joslater/MusselGapeTracker_hardware/KiCad_files/MusselGapeTracker_RevI/MusselGapeTracker_RevI_parts_list.xlsx

Sheet: MusselGapeTracker_RevH
MusselGapeTracker RevI
Part Description | Eagle library part | Manufacturer | Mfr. PN | Quantity (for 1 board) | Digikey PN | Digikey $ | Extended $ | Notes | Alt. Manu PN | Alt. Digikey PN | Alt2 Manu PN | Alt2 Digikey PN
Capacitor, surface mount 1uF 35V, electrolytic, Panasonic FC series, size code B | miller.lbr\CPOL-US | Panasonic | EEE-FC1V1R0R | 2 | PCE4024CT-ND | $0.38 | $0.76
Capacitor, 0603 0.1µF 16V ceramic | miller.lbr\CAP | KEMET | C0603C104K4RACTU | 24 | 399-1096-1-ND | $0.08 | $1.92
Capacitor, 0603 4.7µF 10V ceramic | miller.lbr\CAP | KEMET | C0603C475M8PACTU | 1 | 399-9100-1-ND | $0.73 | $0.73
Capacitor, 0603 10µF X5R | miller.lbr\CAP | Yageo | CC0603KRX5R7BB106 | 1 | 311-3486-2-ND | $0.65 | $0.65 | slater substitute
Resistor, 0603 100ohm | miller.lbr\RESISTOR_SMD | Yageo | RC0603JR-07100RL | 2 | 311-100GRCT-ND | $0.10 | $0.20
Resistor, 0603 4.7k ohm | miller.lbr\RESISTOR_SMD | Yageo | RC0603JR-074K7L | 2 | 311-4.7KGRCT-ND | $0.10 | $0.20
Resistor, 0603 10 k ohm | miller.lbr\RESISTOR_SMD | Yageo | RC0603JR-0710KL | 27 | 311-10KGRCT-ND | $0.10 | $2.70
Resistor, 0603 15 k ohm | miller.lbr\RESISTOR_SMD | Yageo | RC0603JR-0715KL | 1 | 311-15KGRCT-ND | $0.10 | $0.10
Resistor, 0603 100 k ohm | miller.lbr\RESISTOR_SMD | Yageo | RC0603JR-07100KL | 4 | 311-100KGRCT-ND | $0.10 | $0.40
LED, Red 0805 | miller.lbr\LED | Lite-On | LTST-C171KRKT | 1 | 160-1427-1-ND | $0.13 | $0.13
LED, Green 0805 | miller.lbr\LED | Lite-On | LTST-C171GKT | 1 | 160-1423-1-ND | $0.12 | $0.12
BJT NPN Transistor 50V 2A SOT23-3 package | miller.lbr\KSC1623_BJT_TRANSISTOR | Diodes Incorporated | FMMT619TA | 1 | FMMT619CT-ND | $0.62 | $0.62 |  | MMBT6429LT1G | MMBT6429LT1GOSCT-ND | ZXTN25020CFHTA | ZXTN25020CFHTACT-ND
Pushbutton switch SPST tactile, SMD | miller.lbr\PUSHBUTTON_DPST_SMD | Omron | B3S-1000P | 3 | SW836CT-ND | $0.59 | $1.77
Hall effect sensor, Allegro A1395 | miller.lbr\HALL_EFFECT_ALLEGRO_A139* | Allegro | A1395SEHLT-T | 16 | 620-1173-6-ND | $1.22 | $19.52
Real Time Clock, DS3231SN# SO-16 footprint |  | Maxim Integrated | DS3231SN# | 1 | DS3231SN#-ND | $17.21 | $17.21 |  | DS3231M+TRL | DS3231M+TRLCT-ND
CR1220 Battery holder | miller.lbr\CR1220_BATTERY_HOLDER | Keystone | 3000 | 1 | 36-3000-ND | $0.40 | $0.40
CR1220 Battery, lithium |  | Panasonic | CR1220 | 1 | P033-ND | $1.03 | $1.03
JST 4-pin connector, male board mount, through hole | miller.lbr\JST-4PIN | JST Sales | B4B-PH-K-S(LF)(SN) | 16 | 455-1706-ND | $0.20 | $3.20
JST 4-pin connector housing, female |  | JST Sales | PHR-4 | 16 | 455-1164-ND | $0.10 | $1.60
JST crimp-on female connector 24-30AWG |  | JST Sales | SPH-002T-P0.5S | 100 | 455-1127-1-ND | $0.04 | $4.09 |  | 2CTC-R | 2057-2CTC-RCT-ND
4x1 Pin header, female, through hole | miller.lbr\PINHD-1x4BIG_LOCK | Sullins | PPTC041LFBN-RC | 1 | S7002-ND | $0.37 | $0.37
40x1 Pin header, male breakaway |  | Sullins | PRPC040SAAN-RC | 1 | S1011EC-40-ND | $0.55 | $0.55
Inductor, 10µH 150mA, 360 mOhm | miller.lbr\INDUCTOR0805 | Taiyo-Yuden | LBR2012T100K | 1 | 587-2045-1-ND | $0.10 | $0.10
3x2 Pin header | miller.lbr\AVR_SPI_PRG_6 | Molex | 901310763 | 1 | WM8139-ND | $1.80 | $1.80
Voltage regulator MCP-1700T-3002 3.0V (or 3.3V version) | miller.lbr\MCP1700T-3002E/TT | Microchip | MCP1700T-3002E/TT | 1 | MCP1700T-3002E/TTCT-ND | $0.51 | $0.51 |  | MCP1700T-3302E/TT | MCP1700T3302ETTCT-ND
P-Channel 20 V 6A (Ta) 1W (Ta) Surface Mount SOT-23F | miller.lbr\MOSFET-PCHANNEL | Toshiba | SSM3J328R,LF | 1 | SSM3J328RLFCT-ND | $0.42 | $0.42 | slater substitute alt for main | BSH203,215 | 1727-6216-1-ND
Shift register 74HC595D | miller.lbr\74HC595D | Texas Instruments | SN74HC595DR | 2 | 296-31822-1-ND | $0.72 | $1.44
MicroSD card slot 5033981892 | miller.lbr\MICROSD_MOLEX_REVERSECURRENT | Molex | 5033981892 | 1 | WM11190CT-ND | $2.62 | $2.62 | slater substitute
CD74HC4067PWR multiplexer 16 channel (24-TSSOP 4.4x7.8mm, 0.65mm pitch) |  | Texas Instruments | CD74HC4067PWR | 1 | 296-CD74HC4067PWRCT-ND | $1.25 | $1.25 | slater substitute
ATmega328P 32-TQFP | miller.lbr\ATMEGA328_SMT | Microchip | ATMEGA328P-AUR | 1 | ATMEGA328P-AURCT-ND | $2.74 | $2.74 |  | ATMEGA328P-AN | ATMEGA328P-AN-ND
Magnet 0.25"diam x 0.063" thick |  | Radial Magnet Inc | 8195 | 16 | 469-1005-ND | $0.18 | $2.88
2.10mm male board-mount Power Barrel jack | miller.lbr\POWER_JACK_2,1MM | CUI | PJ-202AH | 1 | CP-202AH-ND | $0.75 | $0.75
2.10mm ID x 5.50mm OD Power Barrel Connector |  | Memory Protection Devices | EP501A | 1 | EP501A-ND | $1.71 | $1.71
6x1 Female Pin header, right angle through hole 0.1" | miller.lbr\PINHD-1x6RA | Sullins | PPPC061LGBN-RC | 1 | S5481-ND | $0.64 | $0.64
pushbutton surface mount (small, 1.5mm height) | miller.lbr\PUSHBUTTON_SPST_PTS525_SERIES |  | PTS525SM15SMTR2 LFS | 1 | CKN9104CT-ND | $0.67 | $0.67
2x1 Molex KK male connector, through hole | miller.lbr\22-23-2021 | Molex | 22-23-2021 | 1 | WM4200-ND | $0.16 | $0.16 | optional
2x1 Molex KK female connector |  | Molex | 10-11-2023 | 1 | WM2601-ND | $0.14 | $0.14 | optional
Molex KK crimp-on connector, 24-30AWG |  | Molex | 469990101 | 10 | WM5268-ND | $0.15 | $1.50 | optional
 |  |  |  |  |  | Subtotal | $75.80 | (to build one board)
Cabling
4-conductor cable USB-2.0 28gauge 0.150" diameter |  | CNC Tech | 2725-2828-BE-01000-A | 72 | CN306-100-ND | $0.26 | $18.72 | (varies based on length needs), slater substitute
 |  |  |  | ^ft |  | ^/ft
Circuit Boards - OSH Park
MusselGapeTracker_RevI circuit board (order of 3) |  | https://oshpark.com/shared_projects/NMAsMegv |  | 1 |  | $45.2 | $15.06666667 | (3 boards for this price)
Hall effect sensor board (order in multiples of 3, up to 16 per datalogger) |  | https://oshpark.com/shared_projects/4MzgqBxC |  | 16 |  | $0.50 | $8
Stencil - OSH Stencils
MusselGapeTracker RevI stencil |  | https://oshstencils.com |  | 1 |  | $20 | $0 | (one time purchase)
Hall effect sensor board stencil |  | https://oshstencils.com |  | 1
Amazon |  |  |  |  | Internet link
Diymall 0.96" Inch I2c IIC Serial 128x64 Oled LCD LED White Display Module (GND on Pin 1) |  |  |  | 1 | https://www.amazon.com/gp/product/B076PDVFQD/ | $9.99 | $9.99
micro SD card, 8GB |  |  |  | 1 | http://a.co/8pYRSXH | $6.99 | $6.99
 |  |  |  |  |  | Total | $134.57
One-time supplies
Engineer PA-09 crimping pliers |  |  |  | 1 | http://a.co/9MNSbOH | $44.22 | $0.00 | (one time purchase)
PG7 thread tap (for cable gland mounts to box) |  | McMaster-Carr | 2485A11 | 1 | https://www.mcmaster.com/2485A11/ | $64.50 |  | (one time purchase)
Hot air soldering station |  | Sparkfun | 303D | 1 | https://www.sparkfun.com/products/14557 | $129.95
Soldering iron |  | Sparkfun | Weller WE1010 | 1 | https://www.sparkfun.com/products/14734 | $129.00
Box hardware
Cable Feedthrough 2.5mm-6.5mm Polyamide PG7 Black |  | Altech Corporation | 5308 507 | 16 | 1920-1056-ND | $0.89 | $14.24
Yellow Plastic case, 8.7Lx7.45Wx3.89H |  | Serpac | SE120,YL | 1 | SR-R120-Y-ND | $37.10 | $37.10
Heat shrink 1/4" ID x 4ft - moisture proof adhesive lined, semi-rigid |  | TE Connectivity Raychem Cable Protection | DWFR-8/2-0-STK | 1 | DWFR-8/2-0-STK-ND | $10.81 | $10.81 | FIND SUB
Heat shrink tubing, 0.36" ID before, 0.120" after, adhesive lined 4ft length (outer layer) |  | TE Connectivity Raychem Cable Protection | DWP-125-3/8-0-STK | 1 | DWP038K-ND | $9.06 | $9.06
Heat shrink 1/4" ID x 4ft - moisture proof adhesive lined, semi-rigid |  | TE Connectivity | SCL-1/4-0-STK | 1 | SCL-1/4-0-STK-ND |  |  | FIND SUB
Heat shrink - colored assorted 0.25" ID before |  | Qualtek | Q2-F-RK4-1/4-11-6IN-23 | 1 | Q2F18-KIT-ND | $2.48 | $2.48
D-cell battery holder, 4xD |  | Memory Protection Devices | BH4DL | 1 | BH4DL-ND | $3.51 | $3.51
O-ring 1/8 width dash number 206 - McMasterCarr pk 100 https://www.mcmaster.com/4061t228/ |  | 4061T228 | 4061T228 | 16

Sheet: Pin_assignments_RevH
ATMega Pin # | ATMega Pin Name | Net Name | Description
1 | PD3 | BUTTON2 | Button 2 input
2 | PD4 | LED_RED | Red LED output
3 | GND | GND | ground circuit
4 | VCC | VCC | +3V circuit
5 | GND | GND | ground circuit
6 | VCC | VCC | +3V circuit
7 | PB6 | 32KHZ | clock signal input 32.768KHz
8 | PB7 | none | no function
9 | PD5 | MUX_S1 | Multiplexer address line S1
10 | PD6 | MUX_S2 | Multiplexer address line S2
11 | PD7 | MUX_S3 | Multiplexer address line S3
12 | PB0 | MUX_EN | Multiplexer Enable
13 | PB1 | MUX_S0 | Multiplexer address line S0
14 | PB2 | CS_SD | Chip select for SD card
15 | PB3 | MOSI | SPI Master Out Slave In for SD card and 74HC595D shift register SHIFT_0
16 | PB4 | MISO | SPI Master In Slave Out for SD card
17 | PB5 | SCK | SPI clock pin for SD card and 74HC595D shift registers (pin 11 on shift chips)
18 | AVCC | AVCC | Analog voltage supply
19 | ADC6 | BATT_MONITOR | Battery voltage monitor input
20 | AREF | AREF | Analog voltage reference pin
21 | AGND | AGND | Analog ground
22 | ADC7 | ANALOG_0 | Analog signal input from multiplexer
23 | PC0 | BATT_MONITOR_EN | Battery monitor enable
24 | PC1 | SHIFT_CLEAR | Shift register clear (aka MR Master Reset, SRCLR, pin 10 on 74HC595D chip)
25 | PC2 | CS_SHIFT_REG | Chip select for shift registers (aka LATCH, RCLK, or Slave Select, pin 12 on 74HC595D chip)
26 | PC3 | LED_GRN | Green LED output
27 | PC4 | SDA | I2C data line
28 | PC5 | SCL | I2C clock line
29 | PC6 | RESET | Reset pin
30 | PD0 | TO_FTDI_TX | Serial line
31 | PD1 | TO_FTDI_RX | Serial line
32 | PD2 | BUTTON1 | Button 1 input

Sheet: Part_assignments_RevH
Designator | Package | Quantity | Designation | MF | MPN | OC_FARNELL | OC_NEWARK | PACKAGE | PROD_ID | SPICEMODEL | SUPPLIER | VALUE | VALUE2
C55,C56,C8,C66,C53,C65,C62,C23,C3,C59,C58,C6,C54,C69,C52,C50,C9,C64,C4,C57,C61,C63,C5,C7,C60,C51,C68,C67 | 0603 | 28 | 0.1µF capacitor, 0603 size
C10 | 0603 | 1 | 10µF ceramic capacitor, 0603 size
C1,C2 | PANASONIC_B | 2 | 1µF capacitor, Panasonic Series B
R1,R2 | R0603 | 2 | 100 Ω resistor, 0603 size
R7,R8 | R0603 | 2 | 4.7k Ω resisitor, 0603 size
R30 | R0603 | 1 | 15k Ω resistor, 0603 size
R60,R67,R9,R3,R64,R65,R61,R14,R53,R59,R58,R50,R6,R69,R57,R54,R55,R63,R68,R66,R56,R51,R62,R52 | R0603 | 24 | 10k Ω resistor, 0603 size
R32,R33,R29,R31 | R0603 | 4 | 10k Ω resistor, 0603 size
R28 | R0603 | 1 | 10k Ω resistor, 0603 size
R15,R4,R5 | R0603 | 3 | 100k Ω resistor, 0603 size
P-FET | SOT23-3 | 1 | MOSFET-PCHANNEL BSH203
MCP1700T-3302 | SOT95P237X112-3N | 1 | MCP1700T-3302E/TT voltage regulator
BUTTON2,BUTTON1 | PUSHBUTTON_DPST_SMD | 2 | PUSHBUTTON_DPST_SMDSTANDARD
HALL6,HALL9,HALL10,HALL11,HALL15,HALL0,HALL12,HALL8,HALL2,HALL7,HALL13,HALL4,HALL1,HALL14,HALL3,HALL5 | JST-PH-4-THM | 16 | JST-4PINTH_STRAIGHT - JST PH header, 4-pin
SHIFT_1,SHIFT_0 | SO16 | 2 | 74HC595D
U$2 | SSOP24 | 1 | 74HC4067SM96
INDUCTOR | I_0805 | 1 | 10µH inductor, 0805 size
RESET | PUSHBUTTON_SPST_PTS525_SERIES | 1 | PUSHBUTTON_DPST_SMDSMALL
BJT | SOT23 | 1 | KSC1623_BJT_TRANSISTOR
LED1 | CHIPLED_0805 | 1 | RED_LED, 0805 size
LED2 | CHIPLED_0805 | 1 | GREEN_LED, 0805 size
J1 | 2X3 | 1 | AVR_SPI_PRG_6PTH - 2x3 pin header 0.1" spacing
CR1220_BATTERY0 | CR1220_BATTERY_HOLDER_SMD | 1 | CR1220_BATTERY_HOLDERSMD
JP1 | 1X06-RIGHT_ANGLE | 1 | FTDI_HEADER - right angle 1x6 header, 0.1" spacing
MOLEX_KK0 | 22-23-2021 | 1 | Molex KK 2-pin header (optional)
U$1 | MICROSD_SOCKET_MOLEX_REVERSEMOUNT | 1 | MICROSD_MOLEX_REVERSE SD card slot
UNK2,1MM_JACK0 | POWER_JACK_DC_2,1MM | 1 | POWER_JACK_2,1MM
U3 | SOIC-8_3.9x4.9mm_P1.27mm | 1 | DS3231MZ real time clock (or use U2 - DS32313M+)
U2 | SOIC127P1032X265-16N | 1 | DS3231M+TRL (or use U3 - DS3231MZ)
OLED | 1X04_LOCK | 1 | PINHD-1X4LOCK (OLED display header)
U1 | TQFP32-08 | 1 | ATMEGA328P
 |  |  |  |  | MCP1700T-3302E/TT | 1296592 | 88H9817 | SOT23-3 |  |  | Microchip
 |  |  |  | MOLEX | 22-23-2021 | 1462926 | 25C3832
 |  |  |  |  |  |  |  |  | TRANS-08285
 |  |  |  |  |  |  |  |  |  |  |  | ATMEGA328P
