joslater/MusselGapeTracker_hardware/KiCad_files/MusselGapeTracker_RevI/MusselGapeTracker_RevI_PurchaseList.xlsx

MusselGapeTracker RevI Purchase List
Part Description | Quantity (for 1 board) | Digikey PN | Price $ | Extended $ | Purchase Link
One Board Supplies
Digikey
Capacitor, surface mount 1uF 35V, electrolytic, Panasonic FC series, size code B | 4 | PCE4024CT-ND | $0.38 | $1.52 | https://www.digikey.com/en/products/detail/panasonic-industry/EEE-FC1V1R0R/817433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
Capacitor, 0603 0.1µF 16V ceramic | 30 | 399-1096-1-ND | $0.08 | $2.40 | https://www.digikey.com/en/products/detail/kemet/C0603C104K4RACTU/411095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
Capacitor, 0603 4.7µF 10V ceramic | 3 | 399-9100-1-ND | $0.73 | $2.19 | https://www.digikey.com/en/products/detail/kemet/C0603C475M8PACTU/2200892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
Capacitor, 0603 10µF X5R | 3 | 311-3486-2-ND | $0.65 | $1.95 | https://www.digikey.com/en/products/detail/yageo/CC0603KRX5R7BB106/7164370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
Resistor, 0603 100ohm | 4 | 311-100GRCT-ND | $0.10 | $0.40 | https://www.digikey.com/en/products/detail/yageo/RC0603JR-07100RL/726697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
Resistor, 0603 4.7k ohm | 4 | 311-4.7KGRCT-ND | $0.10 | $0.40 | https://www.digikey.com/en/products/detail/yageo/RC0603JR-074K7L/726785
Resistor, 0603 10 k ohm | 30 | 311-10KGRCT-ND | $0.10 | $3.00 | https://www.digikey.com/en/products/detail/yageo/RC0603JR-0710KL/726700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
Resistor, 0603 15 k ohm | 3 | 311-15KGRCT-ND | $0.10 | $0.30 | https://www.digikey.com/en/products/detail/yageo/RC0603JR-0715KL/726717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
Resistor, 0603 100 k ohm | 6 | 311-100KGRCT-ND | $0.10 | $0.60 | https://www.digikey.com/en/products/detail/yageo/RC0603JR-07100KL/726698
LED, Red 0805 | 2 | 160-1427-1-ND | $0.13 | $0.26 | https://www.digikey.com/en/products/detail/liteon/LTST-C171KRKT/386801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
LED, Green 0805 | 2 | 160-1423-1-ND | $0.12 | $0.24 | https://www.digikey.com/en/products/detail/liteon/LTST-C171GKT/386793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
BJT NPN Transistor 45V 0.2A SOT23-3 package | 2 | MMBT6429LT1GOSCT-ND | $0.17 | $0.34 | https://www.digikey.com/en/products/detail/onsemi/MMBT6429LT1G/919618
Pushbutton switch SPST tactile, SMD | 3 | SW836CT-ND | $0.59 | $1.77 | https://www.digikey.com/en/products/detail/omron-electronics-inc-emc-div/B3S-1000P/368390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
Hall effect sensor, Allegro A1395 | 16 | 620-1173-6-ND | $1.22 | $19.52 | https://www.digikey.com/en/products/detail/allegro-microsystems/A1395SEHLT-T/1190025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
Real Time Clock, DS3231SN# SO-16 footprint | 1 | DS3231SN#-ND | $17.21 | $17.21 | https://www.digikey.com/en/products/detail/analog-devices-inc-maxim-integrated/DS3231SN/1197576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
CR1220 Battery holder | 1 | 36-3000-ND | $0.40 | $0.40 | https://www.digikey.com/en/products/detail/keystone-electronics/3000/227440
CR1220 Battery, lithium | 1 | P033-ND | $1.03 | $1.03 | https://www.digikey.com/en/products/detail/panasonic-energy/CR1220/269740
JST 4-pin connector, male board mount, through hole | 16 | 455-1706-ND | $0.20 | $3.20 | https://www.digikey.com/en/products/detail/jst-sales-america-inc/B4B-PH-K-S/926613
JST 4-pin connector housing, female | 16 | 455-1164-ND | $0.10 | $1.60 | https://www.digikey.com/en/products/detail/jst-sales-america-inc/PHR-4/608606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
JST crimp-on female connector 24-30AWG | 100 | 455-1127-1-ND | $0.04 | $4.09 | https://www.digikey.com/en/products/detail/jst-sales-america-inc/SPH-002T-P0-5S/527359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
4x1 Pin header, female, through hole | 1 | S7002-ND | $0.37 | $0.37 | https://www.digikey.com/en/products/detail/sullins-connector-solutions/PPTC041LFBN-RC/810144
40x1 Pin header, male breakaway | 1 | S1011EC-40-ND | $0.55 | $0.55 | https://www.digikey.com/en/products/detail/sullins-connector-solutions/PRPC040SAAN-RC/2775214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
Inductor, 10µH 150mA, 360 mOhm | 3 | 587-2045-1-ND | $0.10 | $0.30 | https://www.digikey.com/en/products/detail/taiyo-yuden/LBR2012T100K/1788937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
3x2 Pin header | 1 | WM8139-ND | $1.80 | $1.80 | https://www.digikey.com/en/products/detail/molex/0901310763/760853?s=N4IgTCBcDaIOoFkAcBGAzATgLQDkAiIAugL5A
Voltage regulator MCP-1700T-3002 3.0V (or 3.3V version) | 1 | MCP1700T-3002E/TTCT-ND | $0.51 | $0.51 | https://www.digikey.com/en/products/detail/microchip-technology/MCP1700T-3002E-TT/651114
P-Channel 20 V 6A (Ta) 1W (Ta) Surface Mount SOT-23F | 1 | SSM3J328RLFCT-ND | $0.42 | $0.42 | https://www.digikey.com/en/products/detail/toshiba-semiconductor-and-storage/SSM3J328R-LF/2753199
Shift register 74HC595D | 2 | 296-31822-1-ND | $0.72 | $1.44 | https://www.digikey.com/en/products/detail/texas-instruments/SN74HC595DRG3/2600341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
MicroSD card slot 5033981892 | 1 | WM11190CT-ND | $2.62 | $2.62 | https://www.digikey.com/en/products/detail/molex/5033981892/4555393?s=N4IgTCBcDaIOoFkCMKCcAGAwgFQLQDkAREAXQF8g
CD74HC4067PWR multiplexer 16 channel (24-TSSOP 4.4x7.8mm, 0.65mm pitch) | 1 | 296-CD74HC4067PWRCT-ND | $1.25 | $1.25 | https://www.digikey.com/en/products/detail/texas-instruments/CD74HC4067PWR/26639687
ATmega328P 32-TQFP | 1 | ATMEGA328P-AURCT-ND | $2.74 | $2.74 | https://www.digikey.com/en/products/detail/microchip-technology/ATMEGA328P-AUR/2357086
Magnet 0.25"diam x 0.063" thick | 16 | 469-1005-ND | $0.18 | $2.88 | https://www.digikey.com/en/products/detail/radial-magnets-inc/8195/555329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
2.10mm male board-mount Power Barrel jack | 1 | CP-202AH-ND | $0.75 | $0.75 | https://www.digikey.com/en/products/detail/same-sky-formerly-cui-devices/PJ-202AH/408450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
2.10mm ID x 5.50mm OD Power Barrel Connector | 1 | EP501A-ND | $1.71 | $1.71 | https://www.digikey.com/en/products/detail/mpd-memory-protection-devices/EP501A/2439550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
6x1 Female Pin header, right angle through hole 0.1" | 1 | S5481-ND | $0.64 | $0.64 | https://www.digikey.com/en/products/detail/sullins-connector-solutions/PPPC061LGBN-RC/775939
pushbutton surface mount (small, 1.5mm height) | 1 | CKN9104CT-ND | $0.67 | $0.67 | https://www.digikey.com/en/products/detail/c-k/PTS525SM15SMTR2-LFS/1146855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
2x1 Molex KK male connector, through hole | 1 | WM4200-ND | $0.16 | $0.16 | https://www.digikey.com/en/products/detail/molex/0022232021/26667?s=N4IgTCBcDaIOoFkAsYAMqC0A5AIiAugL5A
2x1 Molex KK female connector | 1 | WM2601-ND | $0.14 | $0.14 | https://www.digikey.com/en/products/detail/molex/0010112023/171978?s=N4IgTCBcDaIOoFkwDYAMBGAtAOQCIgF0BfIA
Molex KK crimp-on connector, 24-30AWG | 10 | WM5268-ND | $0.15 | $1.50 | https://www.digikey.com/en/products/detail/molex/0469990101/2713548?s=N4IgTCBcDaIOoFkCsYBsAOAtAOQCIgF0BfIA
Amazon
Diymall 0.96" Inch I2c IIC Serial 128x64 Oled LCD LED White Display Module (GND on Pin 1) | 1 |  | $9.99 | $9.99 | https://www.amazon.com/gp/product/B076PDVFQD/
micro SD card, 16GB | 1 |  | $15.90 | $15.90 | http://a.co/8pYRSXH
OSH Park
MusselGapeTracker_RevI circuit board (order of 3) | 1 |  | $32.45 | $10.81666667 | https://oshpark.com/shared_projects/lujm2dur
Hall effect sensor board (order in multiples of 3, up to 16 per datalogger) | 16 |  | $0.50 | $8 | https://oshpark.com/shared_projects/L2bLLtKh
One Time Purchase Supplies
Digikey
4-conductor cable USB-2.0 28gauge 0.150" diameter | 3 | CN306-100-ND | $25.89 | $77.67 | https://www.digikey.com/en/products/detail/cnc-tech/2725-2828-BE-01000-A/6830180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
Amazon
Engineer PA-09 crimping pliers | 1 |  | $38.95 | $0.00 | http://a.co/9MNSbOH
OSH Stencils
MusselGapeTracker RevI stencil | 1 |  | $12.4 | $12.40 | https://www.oshstencils.com/#
Hall effect sensor board stencil | 1 |  | $5 | $5.00 | https://www.oshstencils.com/#
