joslater/MusselGapeTracker_hardware/KiCad_files/MusselGapeTracker_RevI/MusselGapeTracker_RevI.kicad_pcb

## KiCad design KiCad_files/MusselGapeTracker_RevI/MusselGapeTracker_RevI.kicad_pcb (2026-06-09)

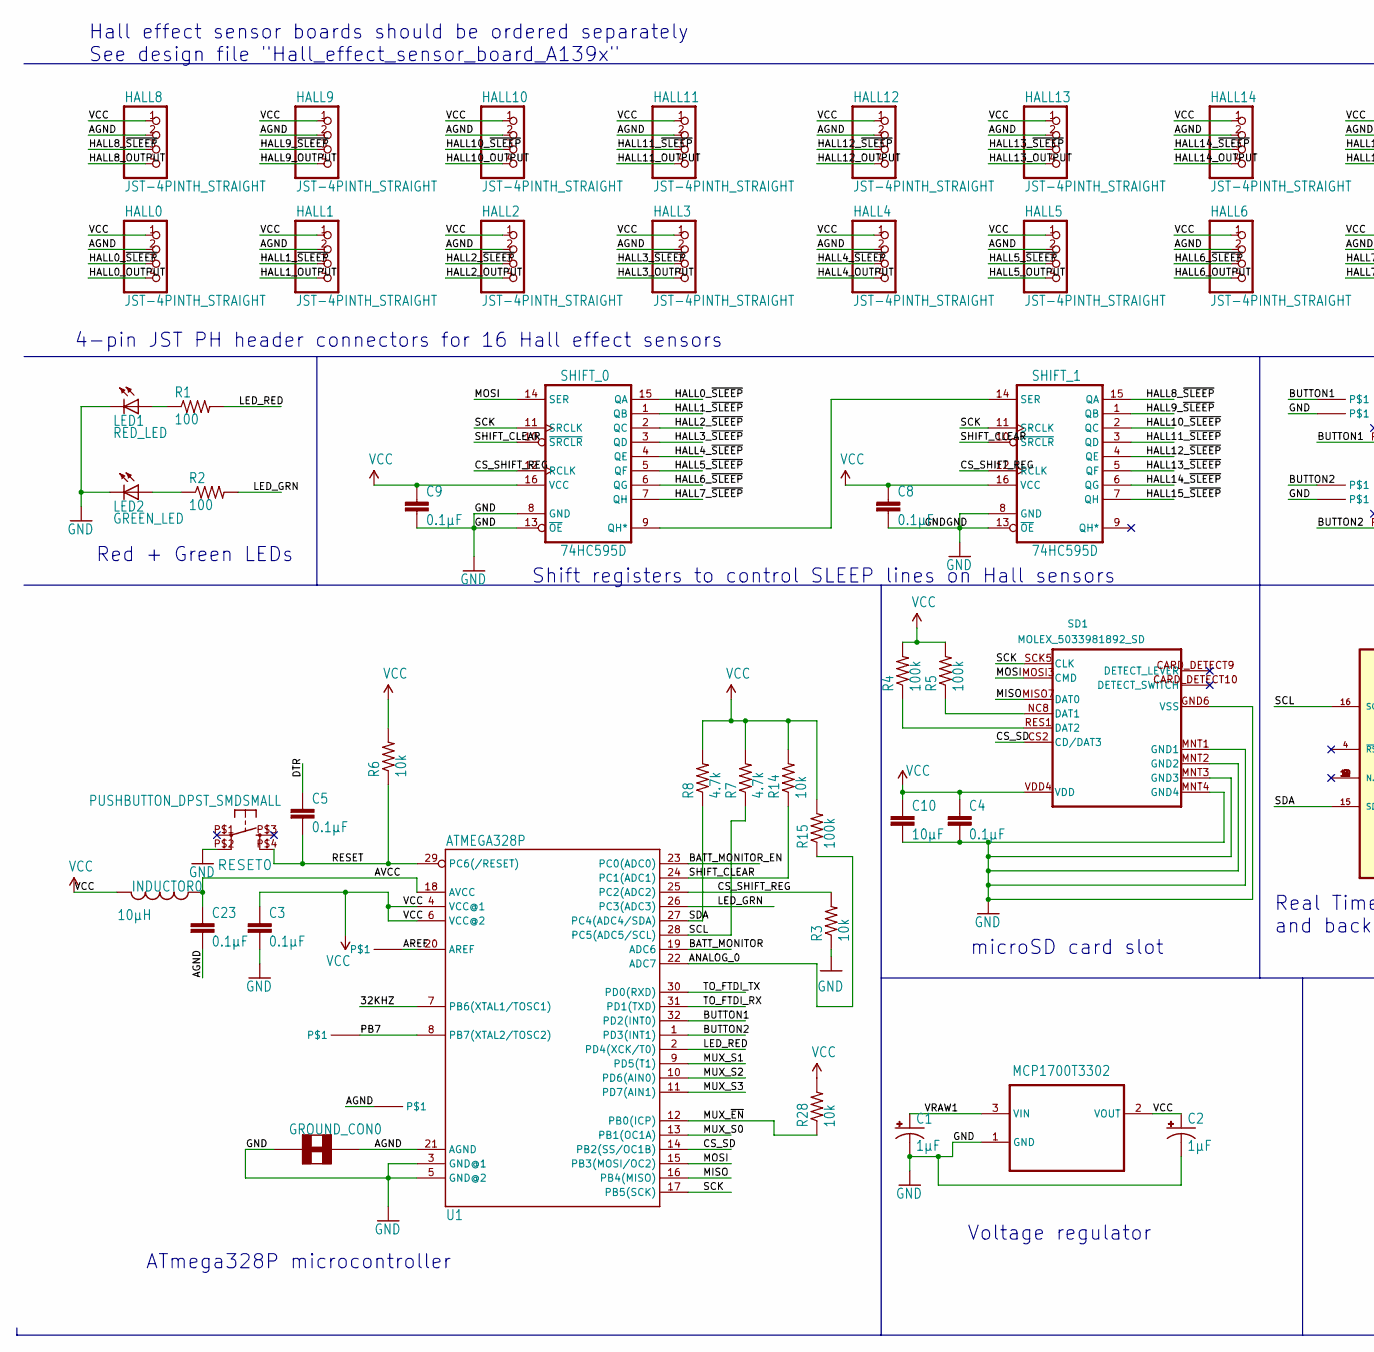
[picture p1: schematic MusselGapeTracker_RevI.kicad_sch, part in row 1, column 1]

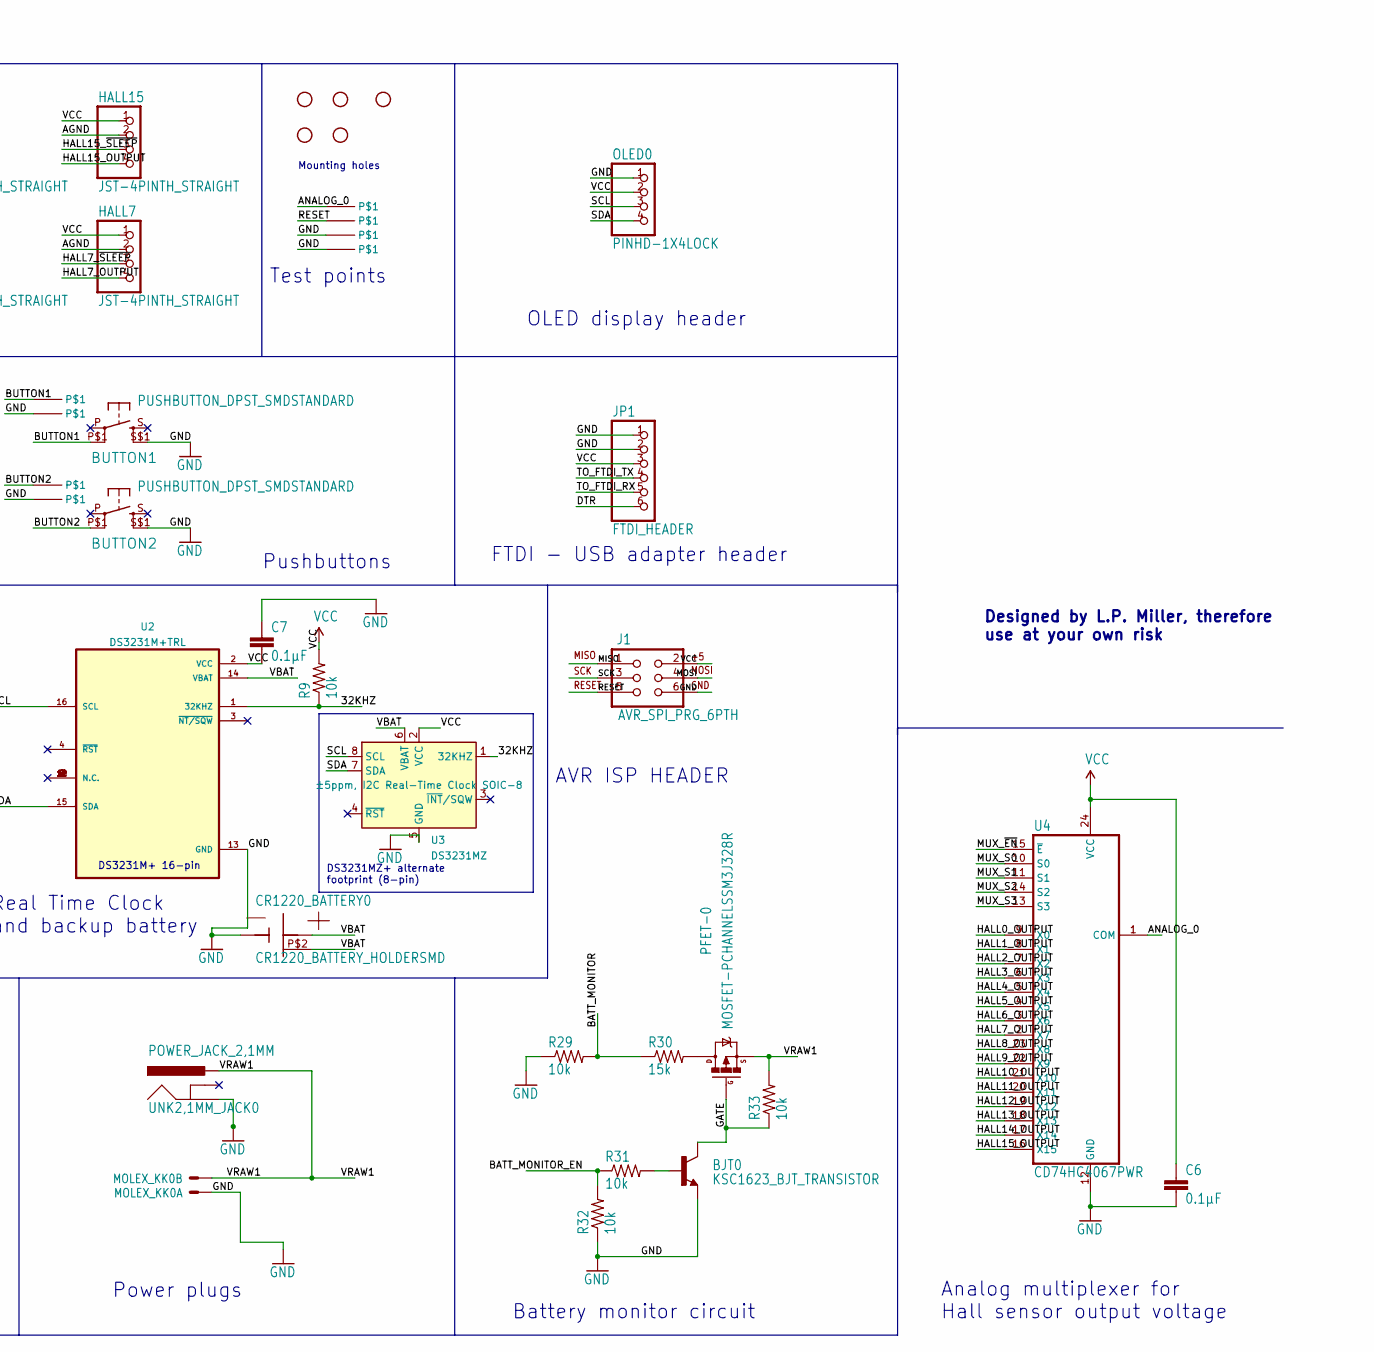
[picture p2: schematic MusselGapeTracker_RevI.kicad_sch, part in row 1, column 2]

Parts:
BJT0: KSC1623_BJT_TRANSISTOR; SOT23
BUTTON1, BUTTON2: PUSHBUTTON_DPST_SMDSTANDARD; PUSHBUTTON_DPST_SMD
C1, C2: 1µF; PANASONIC_B
C3, C4, C5, C6, C7, C8, C9, C23: 0.1µF; R_0603_1608Metric_Pad0.98x0.95mm_HandSolder
C10: 10µF; R_0603_1608Metric_Pad0.98x0.95mm_HandSolder
CR1220_BATTERY0: CR1220_BATTERY_HOLDERSMD; CR1220_BATTERY_HOLDER_SMD
GND0: PINHD-1X1SMALL; 1X01_SMALL
GROUND_CON0: SOLDER_JUMPER_TRACESTANDARD; SJ_2S-TRACE
HALL0, HALL1, HALL2, HALL3, HALL4, HALL5, HALL6, HALL7, HALL8, HALL9, HALL10, HALL11, HALL12, HALL13, HALL14, HALL15: JST-4PINTH_STRAIGHT; JST-PH-4-THM
INDUCTOR0: 10µH; I_0805
J1: AVR_SPI_PRG_6PTH; 2X3
JP1: FTDI_HEADER; 1X06-RIGHT_ANGLE
LED1: RED_LED; CHIPLED_0805
LED2: GREEN_LED; CHIPLED_0805
MCP1700T3302: MCP1700T-3302E/TT; SOT95P237X112-3N
MOLEX_KK0: 22-23-2021
OLED0: PINHD-1X4LOCK; 1X04_LOCK
PB7: PINHD-1X1SMALL; 1X01_SMALL
PFET-0: MOSFET-PCHANNELSSM3J328R; SOT23-3
R1, R2: 100; R_0603_1608Metric_Pad0.98x0.95mm_HandSolder
R3, R6, R9, R14, R28, R29, R31, R32, R33: 10k; R_0603_1608Metric_Pad0.98x0.95mm_HandSolder
R4, R5, R15: 100k; R_0603_1608Metric_Pad0.98x0.95mm_HandSolder
R7, R8: 4.7k; R_0603_1608Metric_Pad0.98x0.95mm_HandSolder
R30: 15k; R_0603_1608Metric_Pad0.98x0.95mm_HandSolder
RESET0: PUSHBUTTON_DPST_SMDSMALL; PUSHBUTTON_SPST_PTS525_SERIES
SD1: MOLEX_5033981892_SD; CONN_503398-1892_MOL; PARTREV A
SHIFT_0, SHIFT_1: 74HC595D; SO16
STANDOFF1, STANDOFF2, STANDOFF3: STAND-OFF4-40; STAND-OFF
STANDOFF4_M2, STANDOFF5_M2: STAND-OFFM2; STAND-OFF_M2
U1: ATMEGA328P; TQFP32-08
U2: DS3231M+TRL; SOIC127P1032X265-16N
U3: DS3231MZ; SOIC-8_3.9x4.9mm_P1.27mm
U4: CD74HC4067PWR; TSSOP-24_4.4x7.8mm_P0.65mm
U$3, U$4, U$6, U$7, U$8, U$9, U$10, U$11, U$17: PINHD-1X1SMALL; 1X01_SMALL
UNK2,1MM_JACK0: POWER_JACK_2,1MM; POWER_JACK_DC_2,1MM

Connections:
/32KHZ: R9.1, U1.7 (PB6(XTAL1/TOSC1)), U2.1 (32KHZ), U3.1 (32KHZ)
/AGND: C23.2, GROUND_CON0.2, HALL0.2, HALL1.2, HALL2.2, HALL3.2, HALL4.2, HALL5.2, HALL6.2, HALL7.2, HALL8.2, HALL9.2, HALL10.2, HALL11.2, HALL12.2, HALL13.2, HALL14.2, HALL15.2, U1.21 (AGND), U$11.1 (P$1_1)
/ANALOG_0: R15.1, U1.22 (ADC7), U4.1 (COM), U$10.1 (P$1_1)
/AREF: U1.20 (AREF), U$17.1 (P$1_1)
/AVCC: C23.1, INDUCTOR0.P$1 (1), U1.18 (AVCC)
/BATT_MONITOR: R29.2, R30.1, U1.19 (ADC6)
/BATT_MONITOR_EN: R31.1, R32.2, U1.23 (PC0(ADC0))
/BUTTON1: BUTTON1.P$1 (P1), U1.32 (PD2(INT0)), U$6.1 (P$1_1)
/BUTTON2: BUTTON2.P$1 (P1), U1.1 (PD3(INT1)), U$8.1 (P$1_1)
/CS_SD: SD1.CS2 (CD/DAT3), U1.14 (PB2(SS/OC1B))
/CS_SHIFT_REG: R3.2, SHIFT_0.12 (RCLK), SHIFT_1.12 (RCLK), U1.25 (PC2(ADC2))
/DTR: C5.1, JP1.6
/GATE: BJT0.3 (C), PFET-0.1 (G), R33.1
/HALL0_OUTPUT: HALL0.4, U4.9 (X0)
/HALL0_~SLEEP: HALL0.3, SHIFT_0.15 (QA)
/HALL1_OUTPUT: HALL1.4, U4.8 (X1)
/HALL1_~SLEEP: HALL1.3, SHIFT_0.1 (QB)
/HALL2_OUTPUT: HALL2.4, U4.7 (X2)
/HALL2_~SLEEP: HALL2.3, SHIFT_0.2 (QC)
/HALL3_OUTPUT: HALL3.4, U4.6 (X3)
/HALL3_~SLEEP: HALL3.3, SHIFT_0.3 (QD)
/HALL4_OUTPUT: HALL4.4, U4.5 (X4)
/HALL4_~SLEEP: HALL4.3, SHIFT_0.4 (QE)
/HALL5_OUTPUT: HALL5.4, U4.4 (X5)
/HALL5_~SLEEP: HALL5.3, SHIFT_0.5 (QF)
/HALL6_OUTPUT: HALL6.4, U4.3 (X6)
/HALL6_~SLEEP: HALL6.3, SHIFT_0.6 (QG)
/HALL7_OUTPUT: HALL7.4, U4.2 (X7)
/HALL7_~SLEEP: HALL7.3, SHIFT_0.7 (QH)
/HALL8_OUTPUT: HALL8.4, U4.23 (X8)
/HALL8_~SLEEP: HALL8.3, SHIFT_1.15 (QA)
/HALL9_OUTPUT: HALL9.4, U4.22 (X9)
/HALL9_~SLEEP: HALL9.3, SHIFT_1.1 (QB)
/HALL10_OUTPUT: HALL10.4, U4.21 (X10)
/HALL10_~SLEEP: HALL10.3, SHIFT_1.2 (QC)
/HALL11_OUTPUT: HALL11.4, U4.20 (X11)
/HALL11_~SLEEP: HALL11.3, SHIFT_1.3 (QD)
/HALL12_OUTPUT: HALL12.4, U4.19 (X12)
/HALL12_~SLEEP: HALL12.3, SHIFT_1.4 (QE)
/HALL13_OUTPUT: HALL13.4, U4.18 (X13)
/HALL13_~SLEEP: HALL13.3, SHIFT_1.5 (QF)
/HALL14_OUTPUT: HALL14.4, U4.17 (X14)
/HALL14_~SLEEP: HALL14.3, SHIFT_1.6 (QG)
/HALL15_OUTPUT: HALL15.4, U4.16 (X15)
/HALL15_~SLEEP: HALL15.3, SHIFT_1.7 (QH)
/LED_GRN: R2.2, U1.26 (PC3(ADC3))
/LED_RED: R1.2, U1.2 (PD4(XCK/T0))
/MISO: J1.1, SD1.MISO7 (DAT0), U1.16 (PB4(MISO))
/MOSI: J1.4, SD1.MOSI3 (CMD), SHIFT_0.14 (SER), U1.15 (PB3(MOSI/OC2))
/MUX_S0: U1.13 (PB1(OC1A)), U4.10 (S0)
/MUX_S1: U1.9 (PD5(T1)), U4.11 (S1)
/MUX_S2: U1.10 (PD6(AIN0)), U4.14 (S2)
/MUX_S3: U1.11 (PD7(AIN1)), U4.13 (S3)
/MUX_~EN: R28.1, U1.12 (PB0(ICP)), U4.15 (~E)
/PB7: PB7.1 (P$1_1), U1.8 (PB7(XTAL2/TOSC2))
/RESET: C5.2, J1.5, R6.1, RESET0.P$4 (S1), U1.29 (PC6(/RESET)), U$3.1 (P$1_1)
/SCK: J1.3, SD1.SCK5 (CLK), SHIFT_0.11 (SRCLK), SHIFT_1.11 (SRCLK), U1.17 (PB5(SCK))
/SCL: OLED0.3, R7.1, U1.28 (PC5(ADC5/SCL)), U2.16 (SCL), U3.8 (SCL)
/SDA: OLED0.4, R8.1, U1.27 (PC4(ADC4/SDA)), U2.15 (SDA), U3.7 (SDA)
/SHIFT_CLEAR: R14.1, SHIFT_0.10 (~SRCLR), SHIFT_1.10 (~SRCLR), U1.24 (PC1(ADC1))
/TO_FTDI_RX: JP1.5, U1.31 (PD1(TXD))
/TO_FTDI_TX: JP1.4, U1.30 (PD0(RXD))
/VBAT: CR1220_BATTERY0.P$1 (VBAT), CR1220_BATTERY0.P$2, U2.14 (VBAT), U3.6 (VBAT)
/VRAW1: C1.+, MCP1700T3302.3 (VIN), MOLEX_KK0.2 (S), PFET-0.2 (S), R33.2, UNK2,1MM_JACK0.P$1 (PWR)
GND: BJT0.2 (E), BUTTON1.S$1 (S1), BUTTON2.S$1 (S1), C1.-, C2.-, C3.2, C4.2, C6.2, C7.1, C8.2, C9.2, C10.2, CR1220_BATTERY0.GND, GND0.1 (P$1_1), GROUND_CON0.1, J1.6, JP1.1, JP1.2, LED1.C, LED2.C, MCP1700T3302.1 (GND), MOLEX_KK0.1 (S), OLED0.1, R3.1, R29.1, R32.1, RESET0.P$2 (P1), SD1.GND6 (VSS), SD1.MNT1 (GND1), SD1.MNT2 (GND2), SD1.MNT3 (GND3), SD1.MNT4 (GND4), SHIFT_0.8 (GND), SHIFT_0.13 (~OE), SHIFT_1.8 (GND), SHIFT_1.13 (~OE), U1.3 (GND@1), U1.5 (GND@2), U2.13 (GND), U3.5 (GND), U4.12 (GND), U$4.1 (P$1_1), U$7.1 (P$1_1), U$9.1 (P$1_1), UNK2,1MM_JACK0.P$2 (GND)
unnamed: BJT0.1 (B), R31.2
unnamed: LED1.A, R1.1
unnamed: LED2.A, R2.1
unnamed: PFET-0.3 (D), R30.2
unnamed: R5.1, SD1.NC8 (DAT1)
unnamed: R4.1, SD1.RES1 (DAT2)
unnamed: SHIFT_0.9 (QH*), SHIFT_1.14 (SER)
VCC: C2.+, C3.1, C4.1, C6.1, C7.2, C8.1, C9.1, C10.1, HALL0.1, HALL1.1, HALL2.1, HALL3.1, HALL4.1, HALL5.1, HALL6.1, HALL7.1, HALL8.1, HALL9.1, HALL10.1, HALL11.1, HALL12.1, HALL13.1, HALL14.1, HALL15.1, INDUCTOR0.P$2 (2), J1.2, JP1.3, MCP1700T3302.2 (VOUT), OLED0.2, R4.2, R5.2, R6.2, R7.2, R8.2, R9.2, R14.2, R15.2, R28.2, SD1.VDD4 (VDD), SHIFT_0.16 (VCC), SHIFT_1.16 (VCC), U1.4 (VCC@1), U1.6 (VCC@2), U2.2 (VCC), U3.2 (VCC), U4.24 (VCC)

Notes on the sheet:
Voltage regulator
OLED display header
DS3231M+ 16-pin
microSD card slot
Real Time Clock and backup battery
Battery monitor circuit
4-pin JST PH header connectors for 16 Hall effect sensors
Hall effect sensor boards should be ordered separately See design file "Hall_effect_sensor_board_A139x"
Pushbuttons
Test points
Designed by L.P. Miller, therefore use at your own risk
ATmega328P microcontroller
FTDI - USB adapter header
Analog multiplexer for Hall sensor output voltage
Power plugs
Mounting holes
Shift registers to control SLEEP lines on Hall sensors
DS3231MZ+ alternate footprint (8-pin)
AVR ISP HEADER
Red + Green LEDs

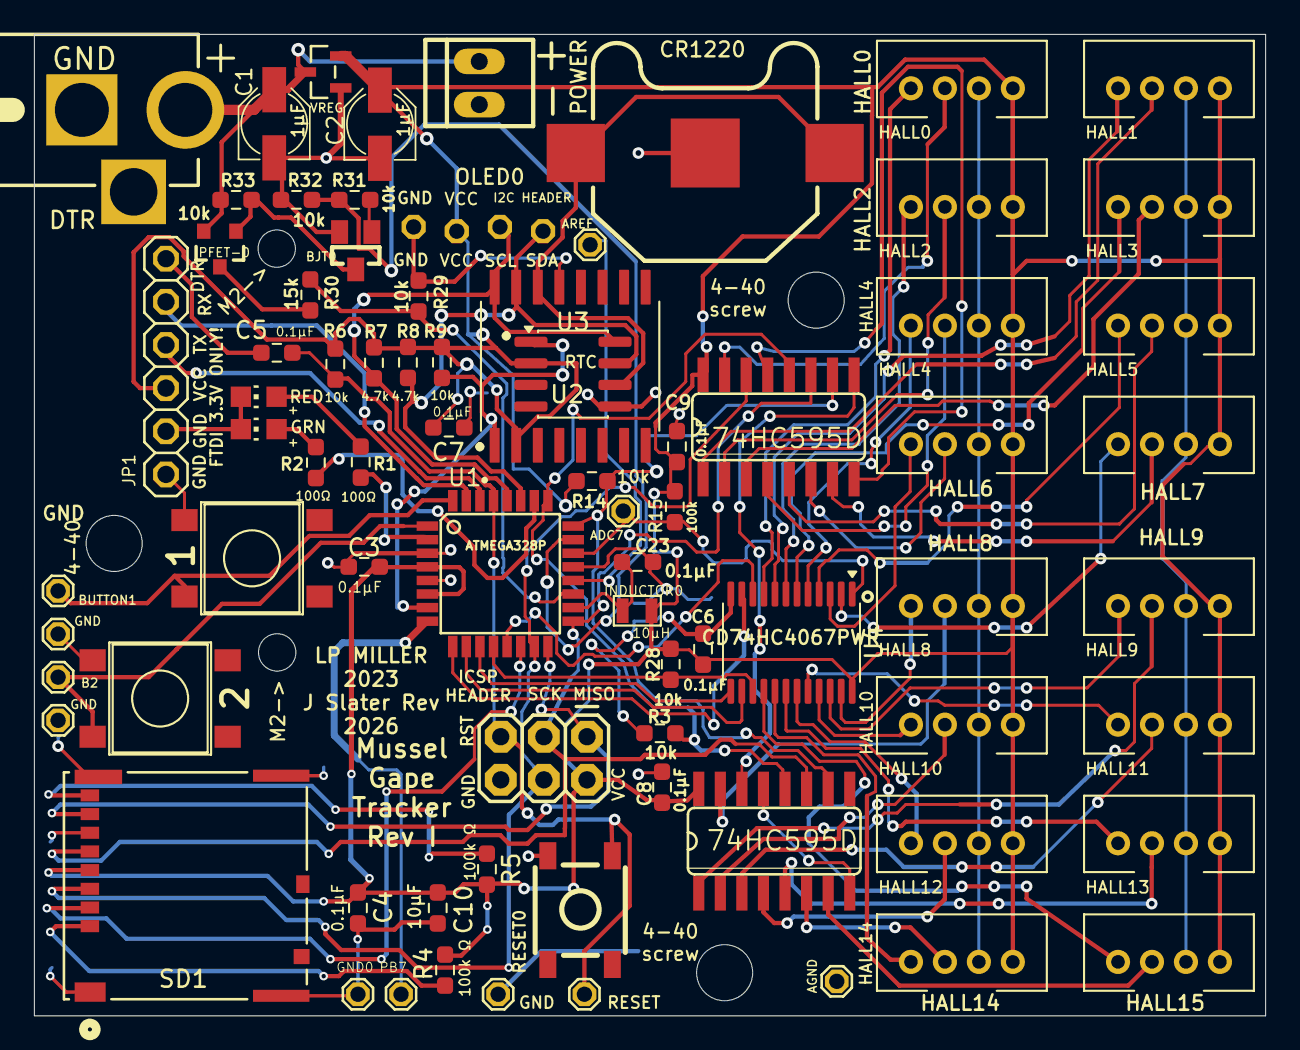
[picture p3: board MusselGapeTracker_RevI.kicad_pcb from above]

Board: 2 copper layers, 72.5 x 57.8 mm, 83 parts (1 on the bottom side), 73 nets.
