joslater/MusselGapeTracker_hardware/KiCad_files/Hall_effect_sensor_board_A139x/Hall_effect_sensor_board_A139x.kicad_pcb

## KiCad design KiCad_files/Hall_effect_sensor_board_A139x/Hall_effect_sensor_board_A139x.kicad_pcb (2026-05-10)

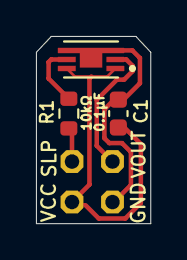
[picture p4: board Hall_effect_sensor_board_A139x.kicad_pcb from above]

Board: 2 copper layers, 6.4 x 10.4 mm, 4 parts (0 on the bottom side), 5 nets.

Parts:
C1: 0.1µF; C_0603_1608Metric
HALL1_HEADER1: PINHD-2X21.5MM_SILK; 2X2_2.25MM
R1: 10kΩ; R_0603_1608Metric
U1: A1395SEHLT-T; SENSOR_A1395SEHLT-T

Connections:
/HALL1_GND: C1.2, HALL1_HEADER1.P$1 (1), U1.3 (GND), U1.4 (GND)
/HALL1_VCC: C1.1, HALL1_HEADER1.P$2 (2), U1.1 (VCC), U1.6 (VREF)
/HALL1_VOUT: HALL1_HEADER1.P$3 (3), U1.2 (OUT)
/HALL1_~SLEEP_IN: HALL1_HEADER1.P$4 (4), R1.1
/~SLEEP1: R1.2, U1.5 (~SLEEP)
