joslater/MusselGapeTracker_hardware/(commit log)

2026-04-09 replace Molex 502774-0891 with GCT MEM2052-00-195-00-A
    [MusselGapeTracker_RevH.kicad_pcb, MusselGapeTracker_RevH.kicad_sch, MusselGapeTracker_RevH_parts_list.xlsx]
2026-04-10 replace Molex 502774-0891 with GCT MEM2052-00-195-00-A
    Pre-existing DRC errors (34) unrelated to this change.
    [MusselGapeTracker_RevH.kicad_pcb]
2026-04-10 Update p-channel mosfet from BSH203 to SSM3J328R
    [MusselGapeTracker_RevH.kicad_pcb, MusselGapeTracker_RevH.kicad_sch, MusselGapeTracker_RevH_parts_list.xlsx]
2026-04-21 Moved changes to Rev I and fixed DRC errors
    Made new copy of KiCad project in Rev I and fixed some electric rules checker errors and warnings and some design rules checker errors and warnings
    [MusselGapeTracker_RevH_parts_list.xlsx, MusselGapeTracker_RevI.kicad_pcb, MusselGapeTracker_RevI.kicad_sch]
2026-04-21 Copied over and updated parts list to Rev I
    [MusselGapeTracker_RevI_parts_list.xlsx]
2026-04-21 Updated parts list with cable sub
    [MusselGapeTracker_RevH_parts_list.xlsx, MusselGapeTracker_RevI_parts_list.xlsx]
2026-05-08 Edits to pcb and parts list
    [MusselGapeTracker_RevI.kicad_pcb]
2026-05-08 parts list edit
    [MusselGapeTracker_RevI_parts_list.xlsx]
2026-05-08 Updated KiCad and Parts list for new SD Card Slot
    Updated KiCad schematic, PCB, and parts list for new SD card slot Molex 5033981892
    [MusselGapeTracker_RevI.kicad_pcb, MusselGapeTracker_RevI.kicad_sch, MusselGapeTracker_RevI_parts_list.xlsx]
2026-05-10 Fix PCB DRC errors and updated parts list
    Updated parts list for more accurate DS3231 chip
    [MusselGapeTracker_RevI.kicad_pcb, MusselGapeTracker_RevI_parts_list.xlsx]
2026-05-10 Created purchase list
    [MusselGapeTracker_RevI.kicad_pcb, MusselGapeTracker_RevI_PurchaseList.xlsx, MusselGapeTracker_RevI_parts_list.xlsx]
2026-05-10 Generate gerber files
    [Hall_effect_sensor_board_A139x-B_Cu.gbr, Hall_effect_sensor_board_A139x-B_Mask.gbr, Hall_effect_sensor_board_A139x-B_Paste.gbr, Hall_effect_sensor_board_A139x-B_Silkscreen.gbr, Hall_effect_sensor_board_A139x-Edge_Cuts.gbr, Hall_effect_sensor_board_A139x-F_Cu.gbr, Hall_effect_sensor_board_A139x-F_Mask.gbr, Hall_effect_sensor_board_A139x-F_Paste.gbr]
2026-05-10 Update purchase list
    [MusselGapeTracker_RevI_PurchaseList.xlsx]
2026-06-03 Fixed SD card mount traces
    Ran SD card traces on bottom instead of top to avoid sd mount prohibition area
    [MusselGapeTracker_RevI.kicad_pcb, MusselGapeTracker_RevI.kicad_sch, MusselGapeTracker_RevI_PurchaseList.xlsx, MusselGapeTracker_RevI_SMT_BOM.csv, MusselGapeTracker_RevI_parts_list.xlsx]
2026-06-09 Generated new gerbers
    Generated new gerber files after modifying SD card traces
    [MusselGapeTracker_RevI-B_Cu.gbr, MusselGapeTracker_RevI-B_Mask.gbr, MusselGapeTracker_RevI-B_Paste.gbr, MusselGapeTracker_RevI-B_Silkscreen.gbr, MusselGapeTracker_RevI-Edge_Cuts.gbr, MusselGapeTracker_RevI-F_Cu.gbr, MusselGapeTracker_RevI-F_Mask.gbr, MusselGapeTracker_RevI-F_Paste.gbr]
2026-07-02 Added updated stencil files
    [Hall_effect_sensor_board_A139x-F_Paste.gbr, Hall_effect_sensor_board_A139x-job.gbrjob, MusselGapeTracker_RevI-F_Paste.gbr, MusselGapeTracker_RevI-job.gbrjob]
